luciobaiocchi/heard/images/img-034.png

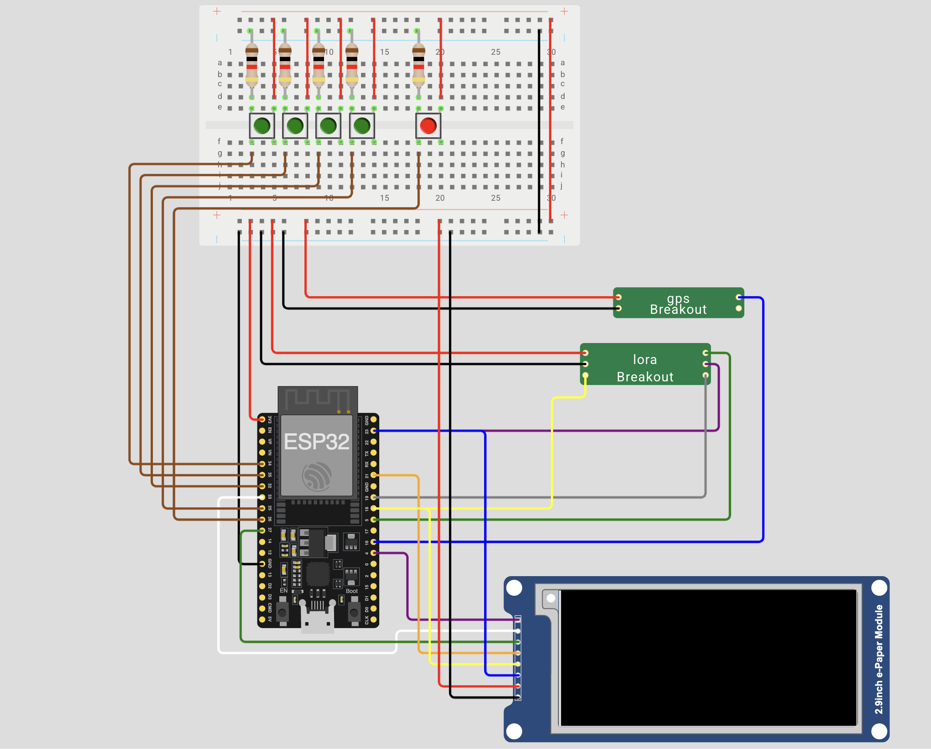
images/img-034.png
