luciobaiocchi/heard/images/PCBV1_3D.png

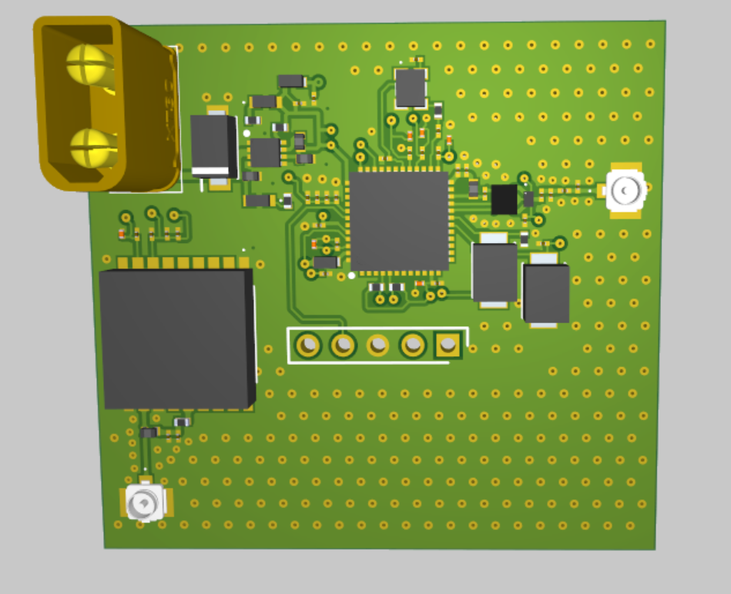
images/PCBV1_3D.png
