luciobaiocchi/heard/images/simulator_viewer.jpg

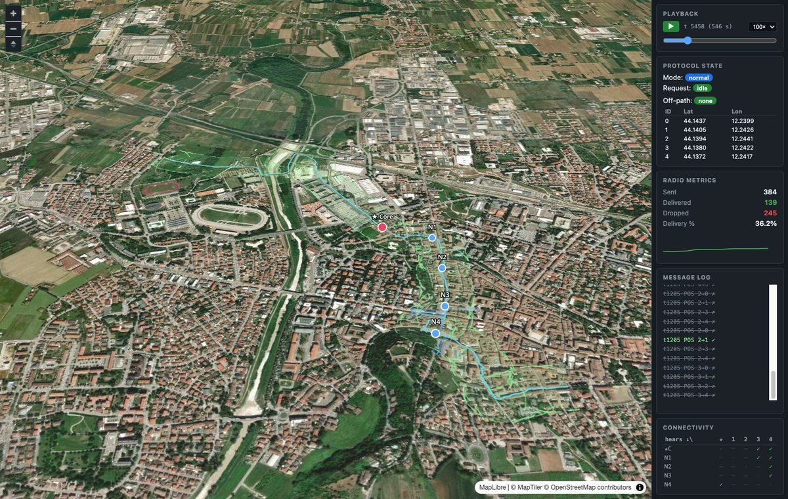
images/simulator_viewer.jpg
