luciobaiocchi/heard/PCB V1/HEARD_BOM.xlsx

Line # | Name | Description | Designator | Quantity | Manufacturer 1 | Manufacturer Part Number 1 | Manufacturer Lifecycle 1 | Supplier 1 | Supplier Part Number 1 | Supplier Unit Price 1 | Supplier Subtotal 1
 | 22u | Capacitor | C100, C101 | 2 | KYOCERA AVX | CM05X5R226M06AH080 | Volume Production | Mouser | 346-CM05X5R226M6AH80 | 0.39 | 0.78
 | 220p | Capacitor | C200, C201 | 2 | TAIYO YUDEN | LMK042B7221KC-W | Volume Production | Arrow Electronics | LMK042B7221KC-W | 0.004 | 0.008
 | 4u7 | Capacitor | C202, C206, C207, C218, C227, C305 | 6 | Murata | GRM035R60J475ME15D | Volume Production | Mouser | 81-GRM035R60J475ME5D | 0.084 | 0.84
 | 470n | Capacitor | C203 | 1 | Murata | GRM022R60J474ME05L | Volume Production | Mouser | 81-GRM022R60J474ME05 | 0.12 | 0.12
 | 10p | Capacitor | C204, C208, C300 | 3 | Yageo Group | CQ0100JRNPO8BN100 | Volume Production | Mouser | 603-CQ0100JRNP8BN100 | 0.017 | 0.17
 | 100n | Capacitor | C205, C210, C213, C214, C215, C216, C217, C219, C220, C228, C301, C302, C303 | 13 | TAIYO YUDEN | MSASL042SB5104MWNA01 | Volume Production | Mouser | 963-MSASL042SB5104MW | 0.017 | 0.221
 | 10n | Capacitor | C209 | 1 | Samsung Electro-Mechanics | CL02A103KQ2NNNC | Volume Production | Arrow Electronics | CL02A103KQ2NNNC | 0.004 | 0.004
 | 1u | Capacitor | C211, C212, C304 | 3 | KYOCERA AVX | CM025X5R105M06AH | Volume Production | Mouser | 581-CM025X5R105M06AH | 0.29 | 0.87
 | 47n | Capacitor | C221, C306 | 2 | Murata | GRM022R60J473ME15L | Volume Production | Arrow Electronics | GRM022R60J473ME15L | 0.0007 | 0.007
 | 68n | Capacitor | C222 | 1 | Murata | GRM022R60J683ME15L | Volume Production | DigiKey | 490-9979-1-ND | 0.1 | 0.1
 | 33p | Capacitor | C223, C226 | 2 | Murata | GRM0225C1H330GA02L | Volume Production | Mouser | 81-GRM0225C1H330GA2L | 0.019 | 0.19
 | DNP | Capacitor | C224, C225 | 2
 | SMAJ5.0AQ-13-F | TVS Diode (Uni-directional) | D100 | 1 | Diodes Inc. | SMAJ5.0AQ-13-F | Volume Production | DigiKey | 31-SMAJ5.0AQ-13-FCT-ND | 0.57 | 0.57
 | STM32WLE5CCU6 | Integrated Circuit | IC200 | 1 | STMicroelectronics | STM32WLE5CCU6 | Volume Production | Mouser | 511-STM32WLE5CCU6 | 8.92 | 8.92
 | BALFHB-WL-05D3 | Integrated Circuit | IC201 | 1 | STMicroelectronics | BALFHB-WL-05D3 | Volume Production | Newark | BALFHB-WL-05D3 | 0.494 | 0.494
 | MAX-M10M-20B | Integrated Circuit | IC300 | 1 | u-blox | MAX-M10M-20B | Unknown | Mouser | 377-MAX-M10M-20B | 6.18 | 6.18
 | XT30PB | Connector | J100 | 1
 | CONUFL001-SMD-T | Connector | J200, J300 | 2 | TE Connectivity | CONUFL001-SMD-T | Volume Production | DigiKey | CONUFL001-SMD-TDKR-ND | 0.61 | 1.22
 | 61300511121 | Connector | J201 | 1
 | 2u2 | Inductor | L100 | 1 | TDK | MLZ1005M2R2WT000 | Volume Production | Conrad | 3555253 | 0.14796 | 0.14796
 | 15u | Inductor | L200 | 1 | TDK | MLZ1608N150LT000 | Volume Production | DigiKey | 445-MLZ1608N150LT000CT-ND | 0.1 | 0.1
 | 3u3 | Inductor | L201 | 1 | Murata | LQM18PN3R3MFCL | Volume Production | DigiKey | 490-LQM18PN3R3MFCLCT-ND | 0.18 | 0.18
 | 82n | Inductor | L203 | 1 | Abracon | AISC-0402-82NJ-T | Volume Production | DigiKey | 535-AISC-0402-82NJ-TCT-ND | 0.22 | 0.22
 | 0 ohm | Inductor | L204 | 1 | Yageo Group | AF0402JR-070RL | Volume Production | DigiKey | 13-AF0402JR-070RLCT-ND | 0.1 | 0.1
 | 10n | Inductor | L300 | 1 | Abracon | AISC-0402-10NJ-T | Volume Production | Mouser | 815-AISC-0402-10N-J | 0.3 | 0.3
 | 19-213_G6C-AN1P2B_3T | LED | LED100, LED101 | 2 | Everlight | 19-213/G6C-AN1P2B/3T | Obsolete
 | TPS62162DSGT | Power Supply | PS100 | 1 | Texas Instruments | TPS62162DSGT | Volume Production | Mouser | 595-TPS62162DSGT | 2.04 | 2.04
 | 1k | Resistor | R100, R101 | 2 | Bourns | CR0402AFX-1001GAS | Volume Production | Mouser | 652-CR0402AFX1001GAS | 0.018 | 0.18
 | 100k | Resistor | R102 | 1 | Vishay | MCS04020C1003FE000 | Volume Production | Arrow Electronics | MCS04020C1003FE000 | 0.0927 | 0.0927
 | 10k | Resistor | R200 | 1 | Walsin Technologies | MR04X1002FTL | Volume Production | Mouser | 791-MR04X1002FTL | 0.1 | 0.1
 | 220 | Resistor | R201 | 1 | Yageo Group | RC0402FR-07220RP | Volume Production | Mouser | 603-RC0402FR-07220RP | 0.1 | 0.1
 | 4k7 | Resistor | R300, R301 | 2 | Yageo Group | AT0402FRE074K7L | Volume Production | Mouser | 603-AT0402FRE074K7L | 0.1 | 0.2
 | 22 | Resistor | R302 | 1 | TE Connectivity | CRG0402F22R | Volume Production | Arrow Electronics | 8-1622826-2 | 0.0007 | 0.0007
 | BGS12WN6E6327XTSA1 | Switch | S200 | 1 | Infineon | BGS12WN6E6327XTSA1 | Volume Production | Arrow Electronics | BGS12WN6E6327XTSA1 | 0.27 | 0.27
 | TSA010A2518A | Switch | S201, S202 | 2
 | TG2520SMN_32.0000M-ECGNNM0 | Crystal or Oscillator | Y200 | 1 | Epson | TG2520SMN 32.0000M-ECGNNM0 | Volume Production | Mouser | 732-2520SMN32ECGNNM0 | 0.76 | 0.76
 | TOTAL |  |  |  |  |  |  |  |  |  | 25.48536
