luciobaiocchi/heard/PCB V1/SCHEMATICS.pdf

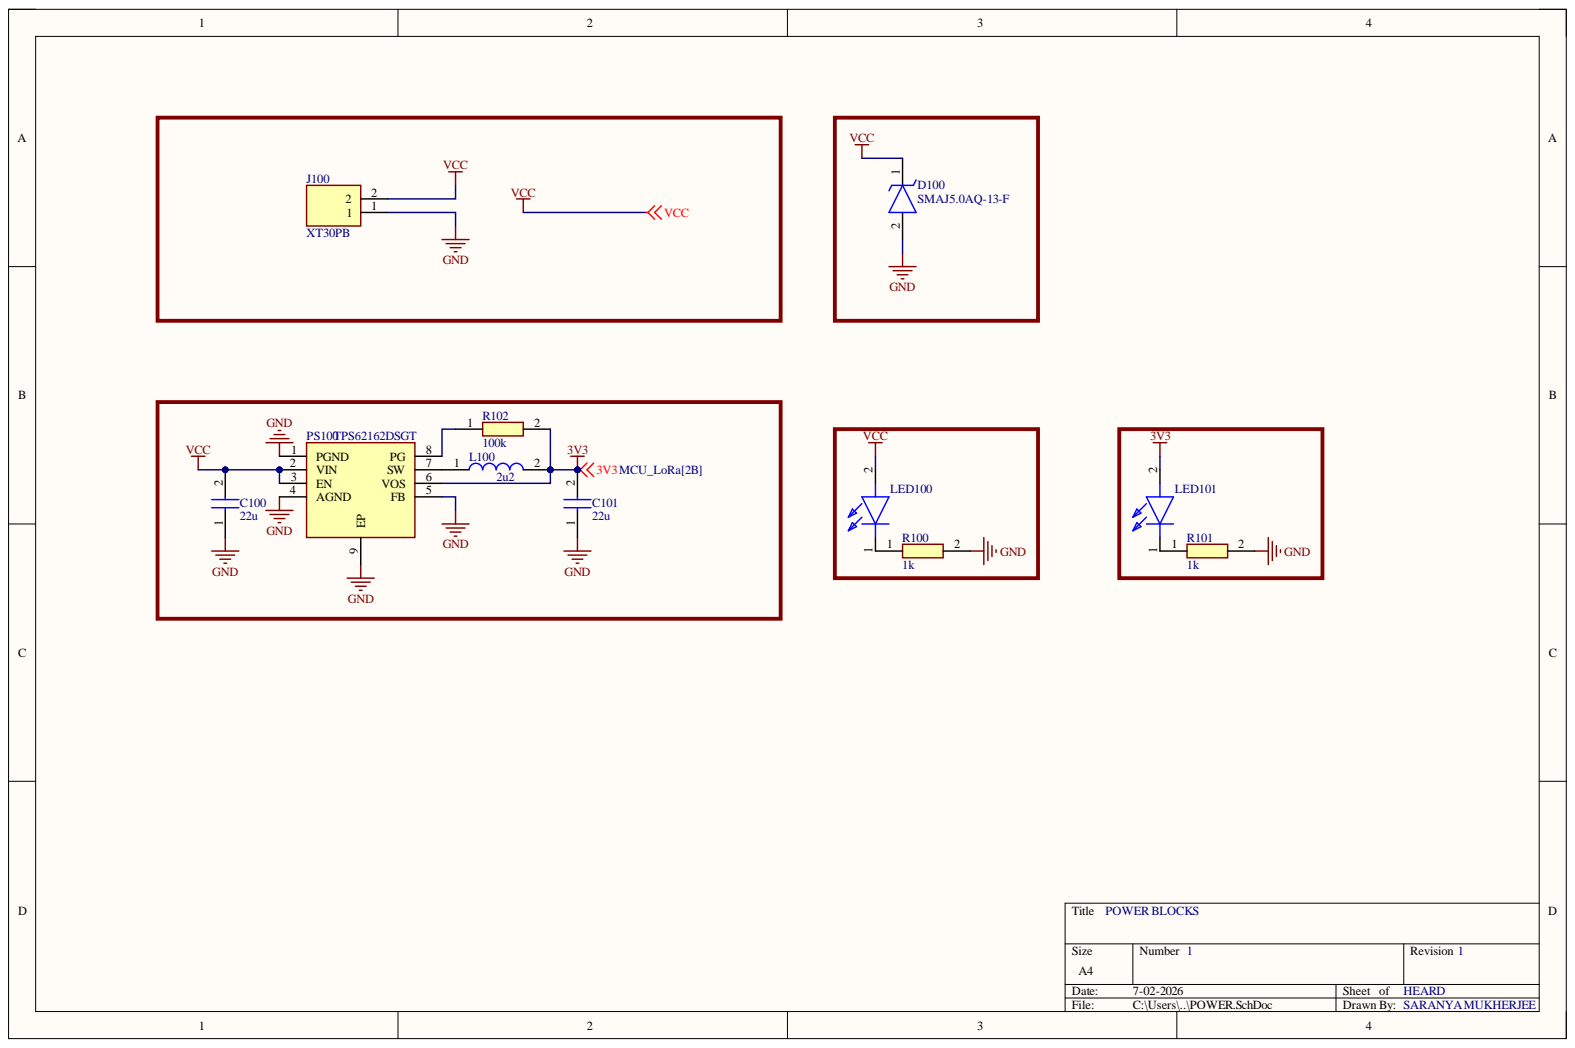
[picture p14: page 1]

Size A4 | Number 1 | Revision 1

Date: 7-02-2026 | Sheet of HEARD
File: C:\Users\..\POWER.SchDoc | Drawn By: SARANYAMUKHERJEE

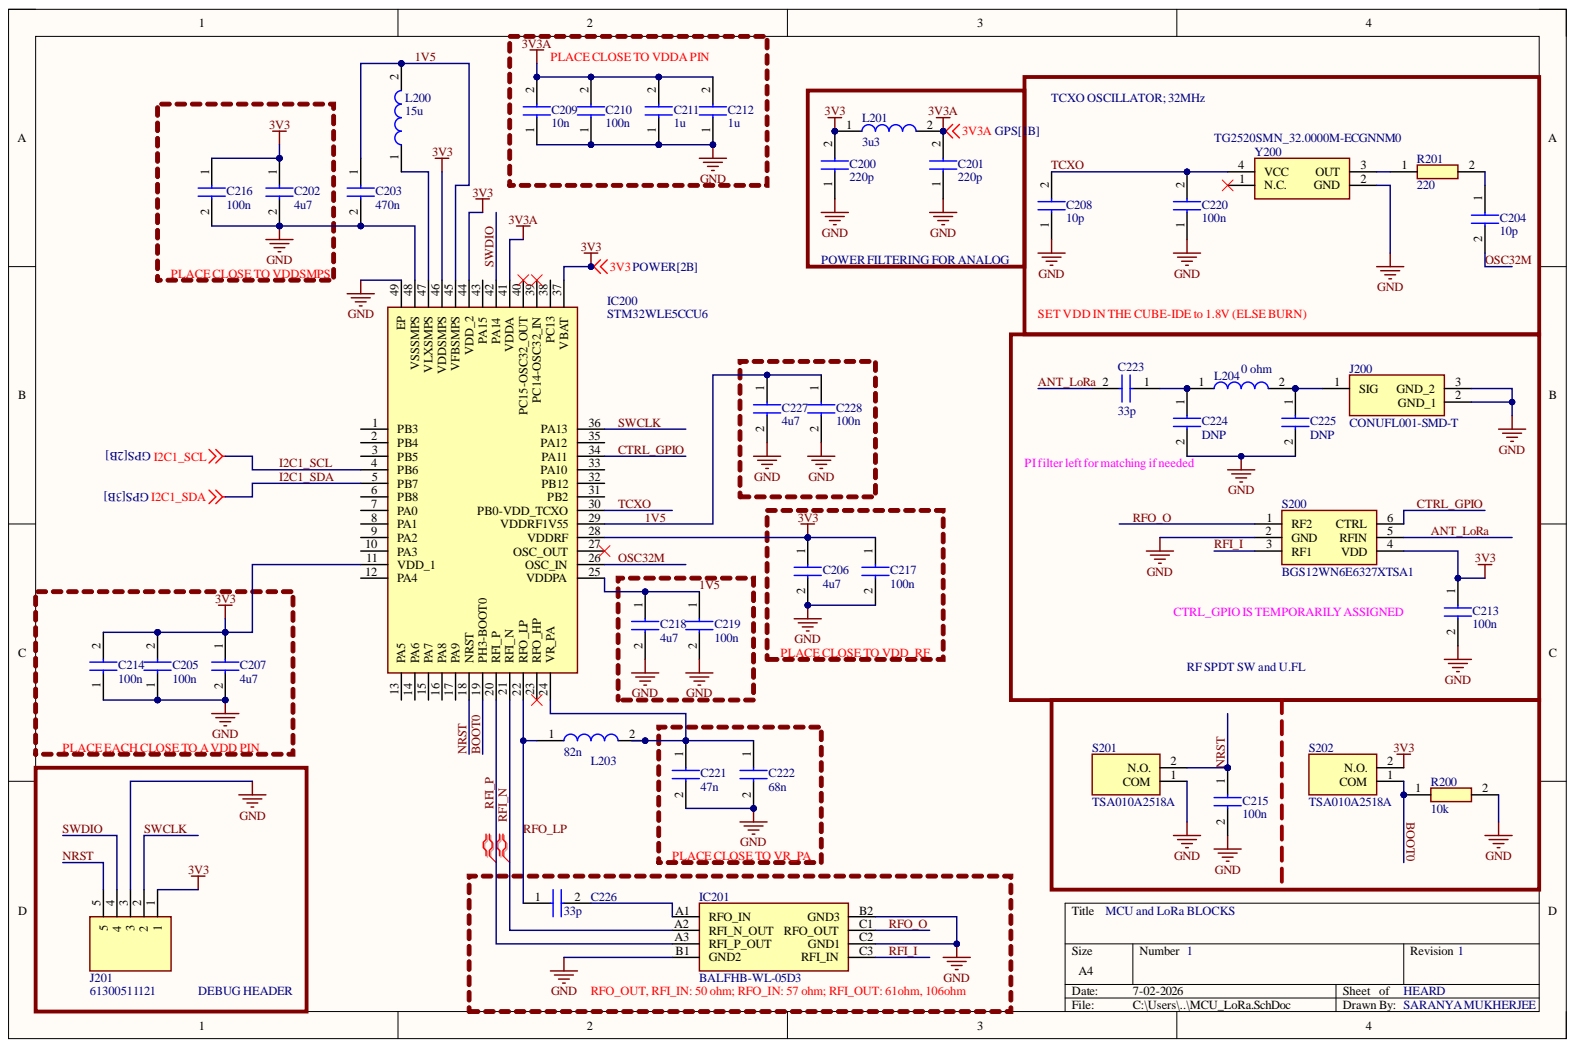
[picture p15: page 2]

PLACE CLOSE TO VDDA PIN

SET VDD IN THE CUBE-IDE to 1.8V (ELSE BURN)

PIfilter left for matching if needed

RF SPDT SW and U.FL

PLACE EACH CLOSE TO AVDD PIN

MCU and LoRa BLOCKS

Date: 7-02-2026 | Sheet of HEARD
File: C:\Users\..\MCU_LoRa.SchDoc | Drawn By: SARANYAMUKHERJEE

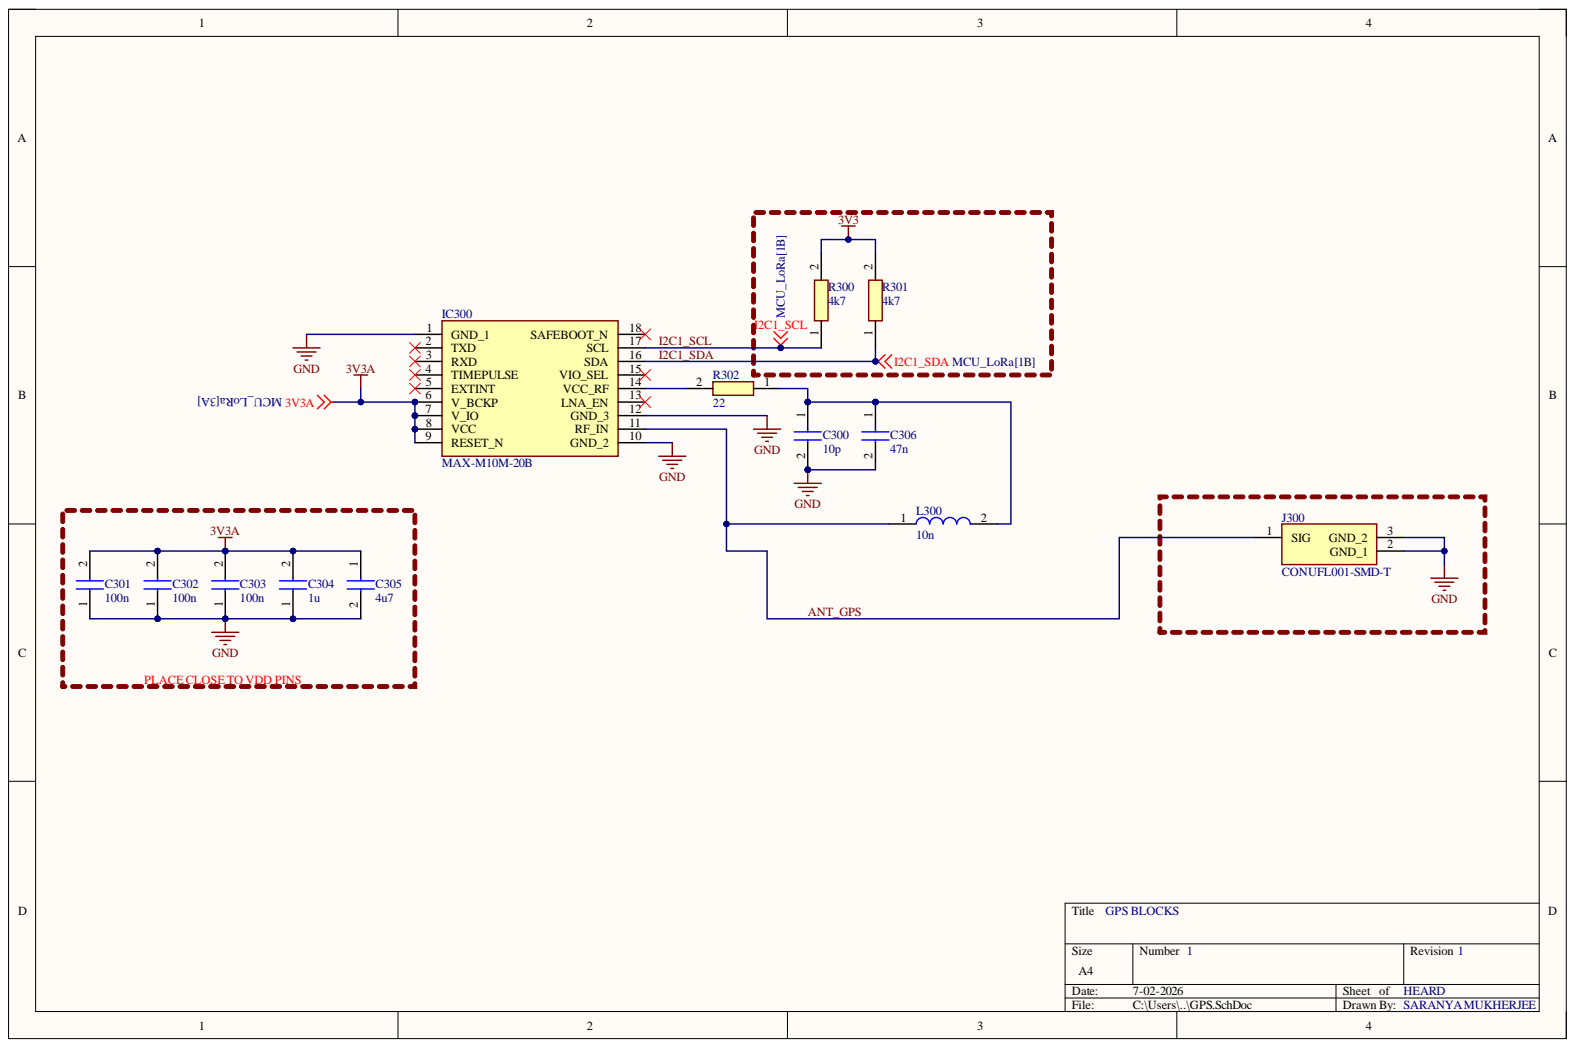
[picture p16: page 3]

Siz e A4 | Numb e r 1 | R evisio n 1

Da te : 7-02-2 0 2 6 | She et of HEA RD
File : C:\Use rs\. .\GP S . S c hD o c | Dr awn B y : SARANY AMUKHER JEE
