luciobaiocchi/heard/(commit log)

2026-06-11 HEARD: offline LoRa group-safety system for hikers — initial public release
    Firmware (ESP32/FreeRTOS) for Core and Node devices, GPX path tools,
    and a firmware-in-the-loop simulator with a 3D web replay viewer.
2026-06-11 Add device photos, concept renders and simulator demo GIF to README
    - Hero: printed Core prototype (external + internals, EXIF stripped)
    - Simulator section now uses the animated replay demo
    - Restore img-004/img-021 still referenced by HEARD_PROJECT.md
2026-06-11 README: clarify Node firmware status
    The protocol is shared ConnectionManager code (role selected by device
    ID); dispositivo_figlio currently holds only a LoRa receiver test sketch.
2026-06-11 README: frame thesis scope (first demo + architecture) and planned testing/improvements
2026-06-12 Add CI pipeline and protocol/terrain/recorder regression tests
    CI (GitHub Actions): simulator job builds heard_sim from the firmware
    sources and runs pytest; firmware job compiles both PlatformIO projects;
    web job syntax-checks the viewer ES modules.
    New tests (+30): C++ ConnectionManager regressions (request interval,
    round completion, unreachable-group retry), unicast overhearing,
    knife-edge/tile/elevation terrain units, trace schema, determinism,
    radio radius flags. The multi-hop POS aggregation gap these tests found
    is a strict xfail tracked in issue #2.
2026-06-12 Implement multi-hop relay chain; fix core round accounting; add logo
    NodeDevice now implements all three protocol legs: REQ relay (as
    before), WAIT announcements upstream for downstream devices the core
    cannot hear, and forwarding of downstream POS reports toward the core.
    Round detection keys off any REQ (relay-only nodes never hear the core
    directly).
    ConnectionManager::handlePositionData now erases every parsed entry from
    waitingDevices/pendingDevices, not just the sender — previously a
    multi-hop round could only end by global timeout even with all positions
    delivered.
    Relay xfail flipped to passing tests; added 3-hop chain and clean round
    completion regressions (91 passed).
    README: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
    [ConnectionManager.cpp]
2026-06-12 Implement node role in firmware ConnectionManager
    The C++ ConnectionManager now implements both protocol roles, selected
    by device id (0 = core, otherwise node):
    - role check: only the core auto-starts polling rounds (taskLoop and
    simulator step path)
    - node REQ handling: forwards the REQ with its id appended to the hop
    list, defines its upstream, and answers once per round with its own
    position; round boundaries are detected by time gap (CM_ROUND_GAP_MS,
    new in config.h) since relay-only nodes never hear the core directly
    - WAIT leg: a relay announces downstream devices upstream so the core
    keeps the round open for members it cannot hear; WAITs from deeper
    chains are forwarded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
2026-06-12 Docs: SIMULATION.md deep dive and ROADMAP; link enclosure release
    SIMULATION.md explains the three-layer architecture, the tick model,
    movement/excursion kinematics, the radio and terrain channel models, the
    protocol timing inequality chain, and the rationale for every parameter.
    ROADMAP.md lays out next steps: standalone node build, simulator
    improvements (collisions/airtime, battery model, Monte Carlo, radio-model
    fitting), and MeshCore/Meshtastic as alternative transport layers.
2026-06-12 README: enclosure files release pending final models
2026-06-13 Docs: expand ROADMAP with detection criteria, path recording, hardware
    - Safety detection criteria (off-path, fall-behind, isolation distances),
    proposed by https://www.reddit.com/user/aemfbm/
    - On-device path recording as a future feature (verified: no recording
    code, persistence, or button handler exists in firmware today)
    - Hardware and enclosure: PCB design, battery integration, haptic
    feedback, waterproof case
2026-06-13 Rename firmware dirs to core/ and node/; flag Node as unimplemented
    - code/dispositivo_madre -> code/core, code/dispositivo_figlio -> code/node
    - propagate the rename everywhere: CI build matrix, CMake FIRMWARE_ROOT,
    all docs, and Python comments (zero references remain)
    - docs now flag the Node firmware as not yet implemented (README and
    HEARD_PROJECT device tables/tree, simulator ARCHITECTURE); see #1
    - fix the CONTRIBUTING language note the blanket rename had broken
    Simulator rebuilt against core/: 98 tests pass.
    [Connection.cpp, ConnectionManager.cpp, Constants.h, DisplayEInk.h, GeoPoint.cpp]
2026-06-15 Docs: ROADMAP help-wanted for Wokwi-to-PCB conversion (PCBWay sponsor)
2026-06-15 README: add PCBWay PCB sponsor section with disclosure
2026-06-17 README: link Core enclosure STLs (release enclosure-v0.1)
2026-07-07 feat(hardware): add V1 PCB design, manufacturing files, and EM simulations - Adds ODB++ and Gerber fabrication files for the 4-layer V1 board. - Includes schematics (HEARD.pdf) and Bill of Materials 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
    [HEARD_BOM.xlsx]
2026-07-21 Remove dead/broken headers from core firmware
    DisplayOled.h was malformed C++ (stray colon in the class declaration,
    a GeoPoint constructor declared inside DisplayOled, an inline-initialised
    Adafruit_SSD1306 member) and would not compile if ever included. Button.h
    and Lora_module.h were empty (0 bytes). None of the three were referenced
    anywhere in the firmware, which uses DisplayEInk for the display.
    Fixes #19
    Claude-Session: https://claude.ai/code/session_01F3LqmMGFMVq98Eg5XK5Nce
